dbychkov/PiCard/doc/ZX_PICARD_V3.pdf

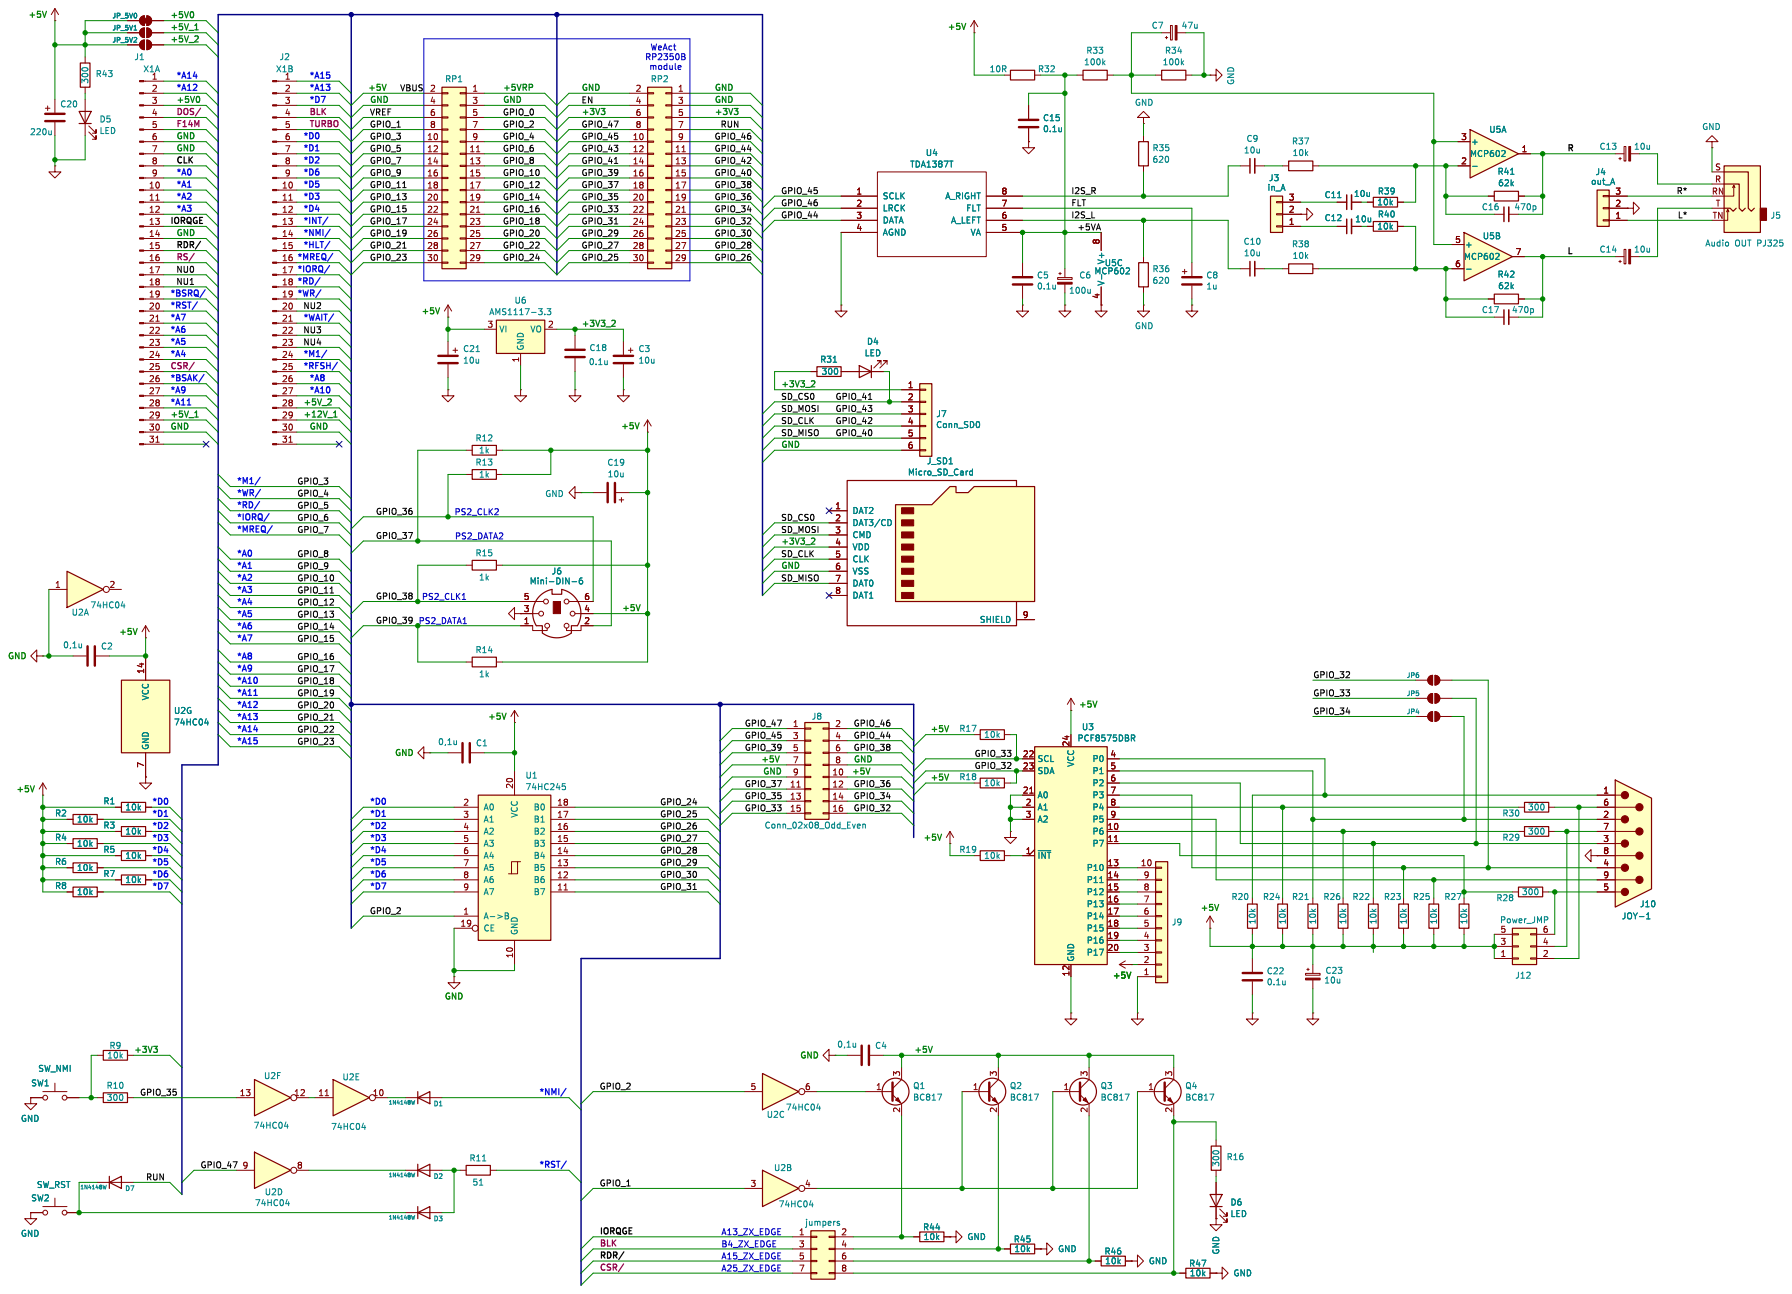
[picture p1: page 1]
